ElBarbs/CART360-ProjectProposal/Media/InitialPrototype.png

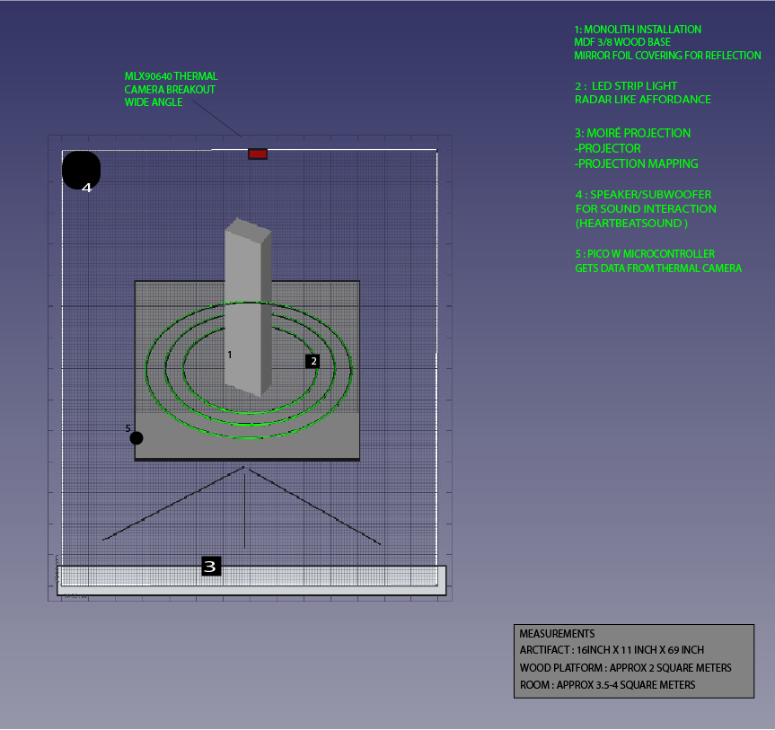
Media/InitialPrototype.png
