ElBarbs/CART360-ProjectProposal/Media/Platform.jpg

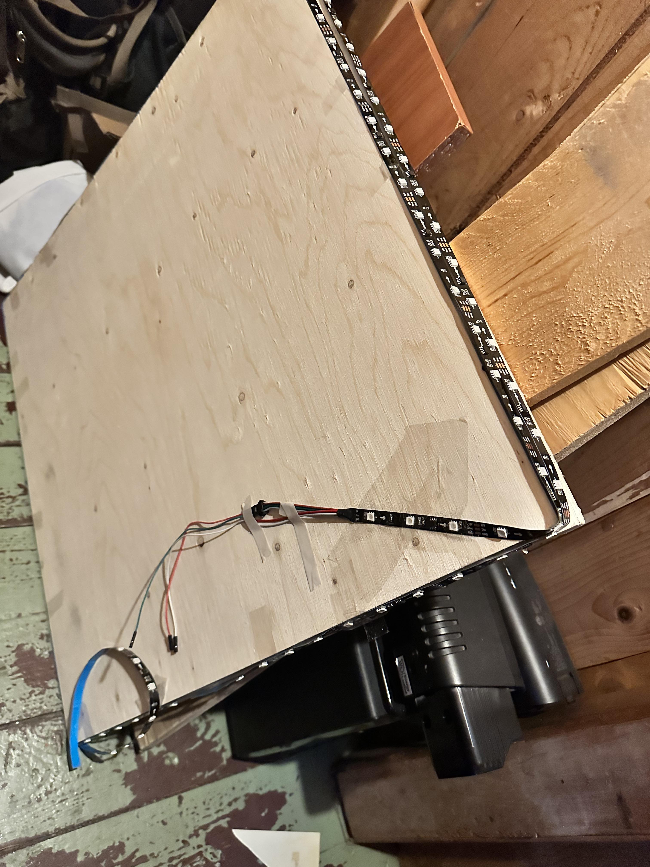
Media/Platform.jpg
