ElBarbs/CART360-ProjectProposal/Circuits/CircuitLEDs.png

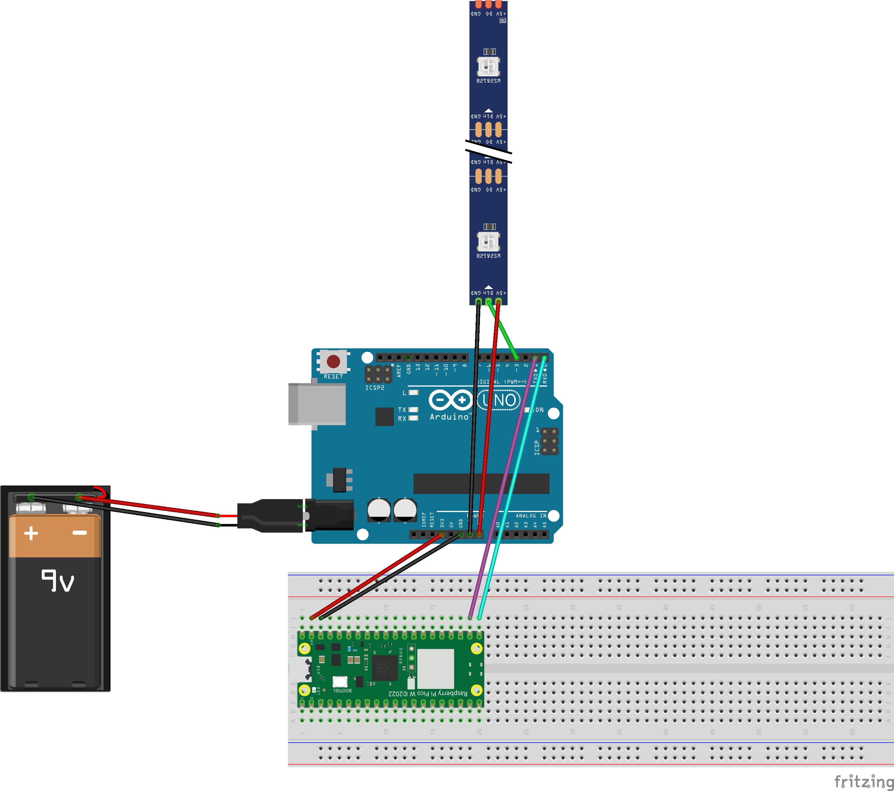
Circuits/CircuitLEDs.png
