ElBarbs/CART360-ProjectProposal/Circuits/CircuitThermalCamera.png

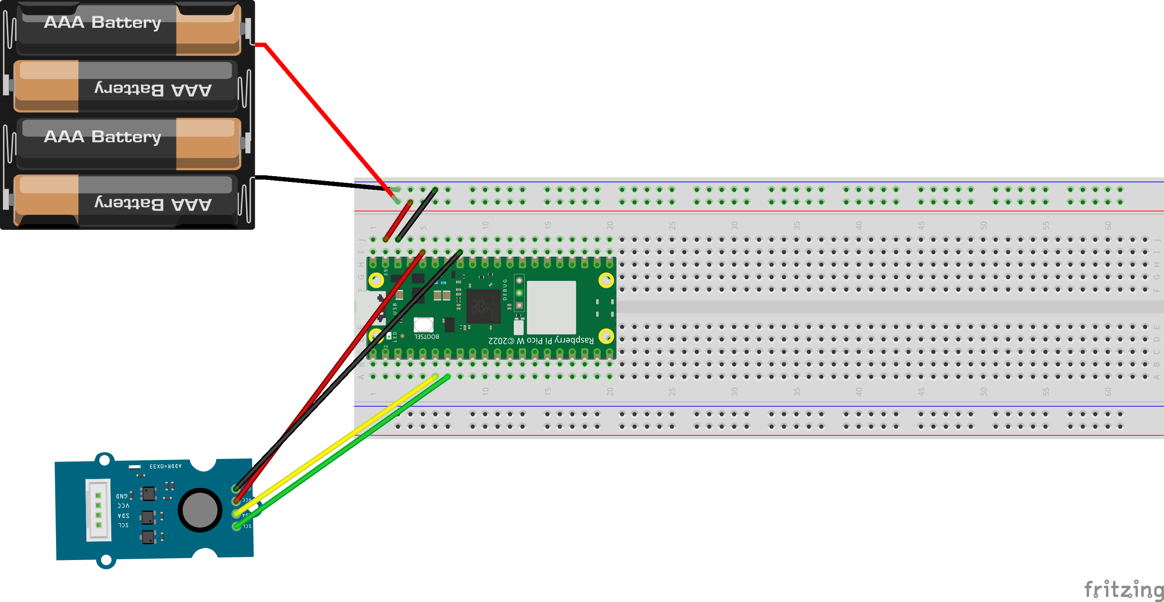
Circuits/CircuitThermalCamera.png
