ElBarbs/CART360-ProjectProposal/(commit log)

2023-12-03 Update README.md
    Updated "Materials" section.
2023-12-03 Update README.md
    Fixed issue in "Materials" section.
2023-12-03 - Added code for Pico WH.
2023-12-03 - Added circuits.
2023-12-03 Added LED strip lights model.
2023-12-03 - Added code for Arduino UNO R3. - Added images of monolith/platform.
2023-12-03 - Added Sonic Pi code. - Added license file for the Pico WH code. - Added PDF report.
